koson/SmartFarmMySensors_ArduinoNano/3D/arduino-nano--1.snapshot.4/arduino nano290313/nanoblack_mask.bmp

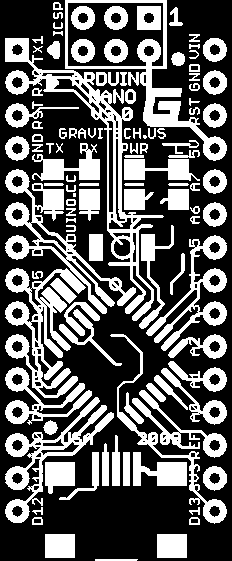
3D/arduino-nano--1.snapshot.4/arduino nano290313/nanoblack_mask.bmp
