koson/SmartFarmMySensors_ArduinoNano/3D/arduino-nano--1.snapshot.4/arduino nano290313/reset button.SLDASM

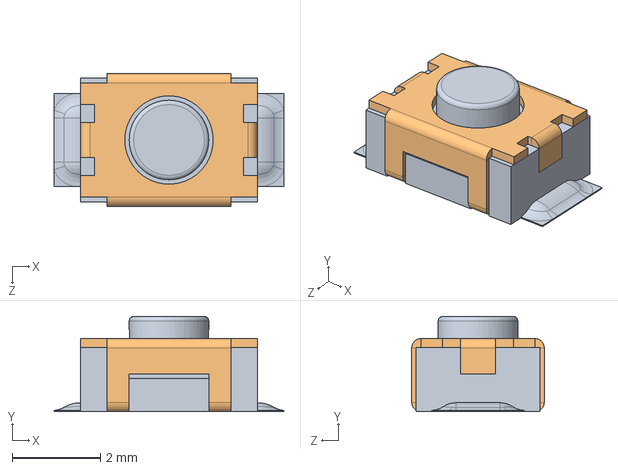
[picture p7: CAD file, 2025-02-11]
3D/arduino-nano--1.snapshot.4/arduino nano290313/reset button.SLDASM
5.20 x 2.15 x 3.00 mm
reset core
reset shell
