koson/SmartFarmMySensors_ArduinoNano/3D/arduino-nano--1.snapshot.4/arduino nano290313/MINIUSB - MEASURED.SLDASM

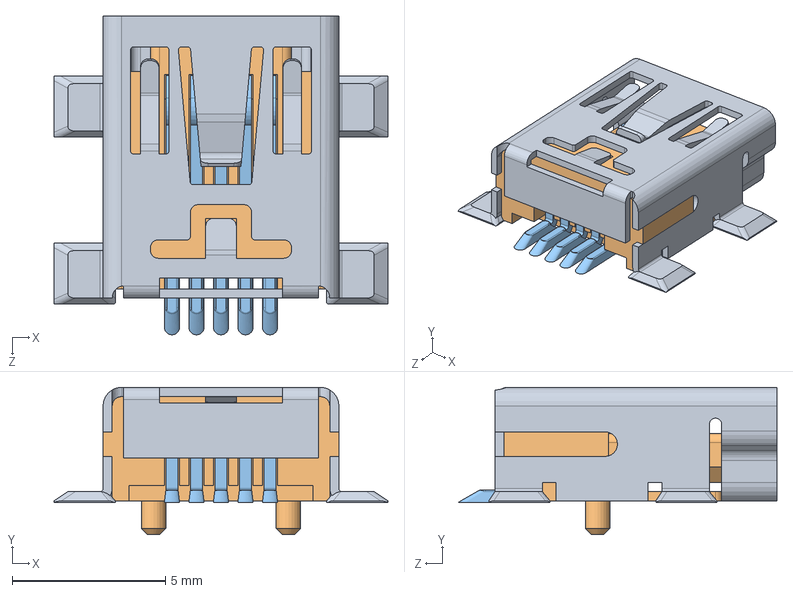
[picture p9: CAD file, 2025-02-11]
3D/arduino-nano--1.snapshot.4/arduino nano290313/MINIUSB - MEASURED.SLDASM
10.9 x 4.80 x 10.4 mm
MINIUSBSHELL
MINIUSBCORE
MINI USB CONTACT x 5
