koson/SmartFarmMySensors_ArduinoNano/3D/arduino-nano--1.snapshot.4/arduino nano290313/2pin_header__02.sldprt

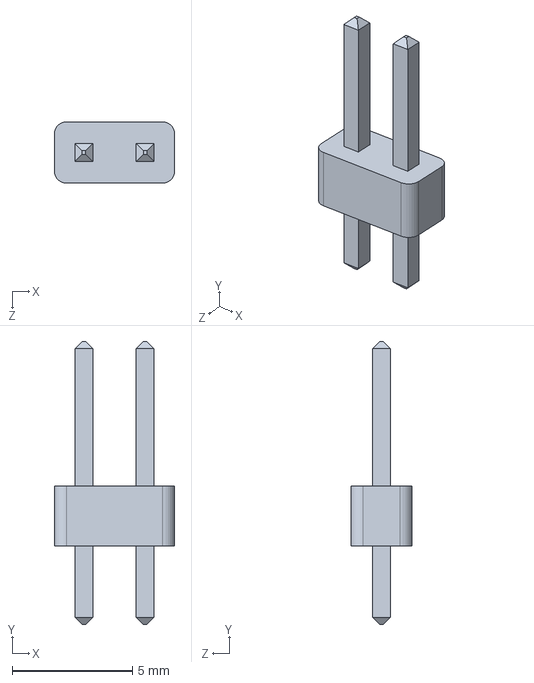
[picture p10: CAD file, 2025-02-11]
3D/arduino-nano--1.snapshot.4/arduino nano290313/2pin_header__02.sldprt
5.00 x 11.8 x 2.54 mm
