koson/SmartFarmMySensors_ArduinoNano/3D/RadioFrequencyCommunicationModule_nRF24L01.STEP

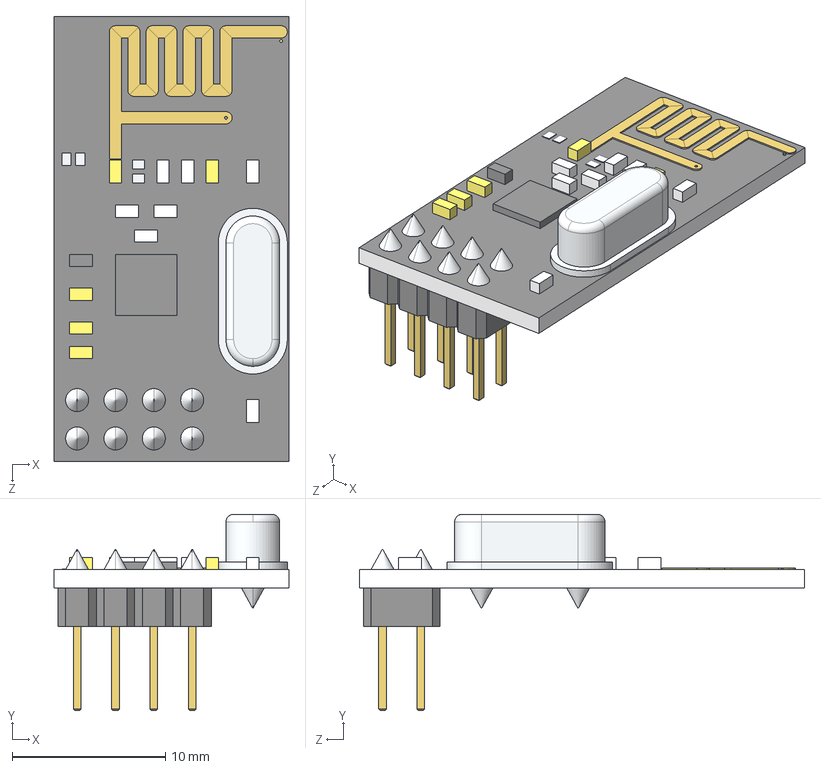
[picture p11: CAD file, 2025-02-11]
3D/RadioFrequencyCommunicationModule_nRF24L01.STEP
15.3 x 12.8 x 29.0 mm
