koson/SmartFarmMySensors_ArduinoNano/3D/arduino-nano--1.snapshot.4/arduino nano290313/reset core.SLDPRT

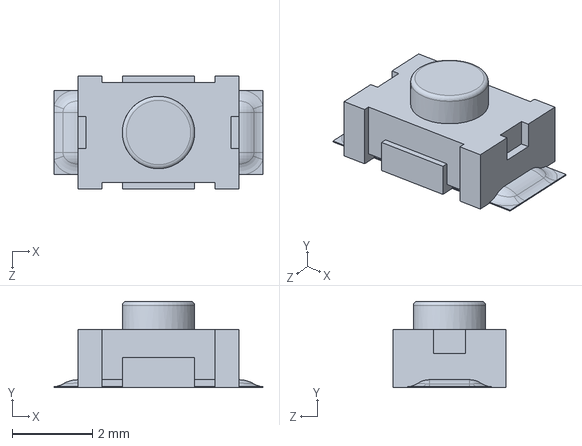
[picture p12: CAD file, 2025-02-11]
3D/arduino-nano--1.snapshot.4/arduino nano290313/reset core.SLDPRT
5.20 x 2.15 x 2.80 mm
