koson/SmartFarmMySensors_ArduinoNano/3D/arduino-nano--1.snapshot.4/arduino nano290313/cap106C.SLDPRT

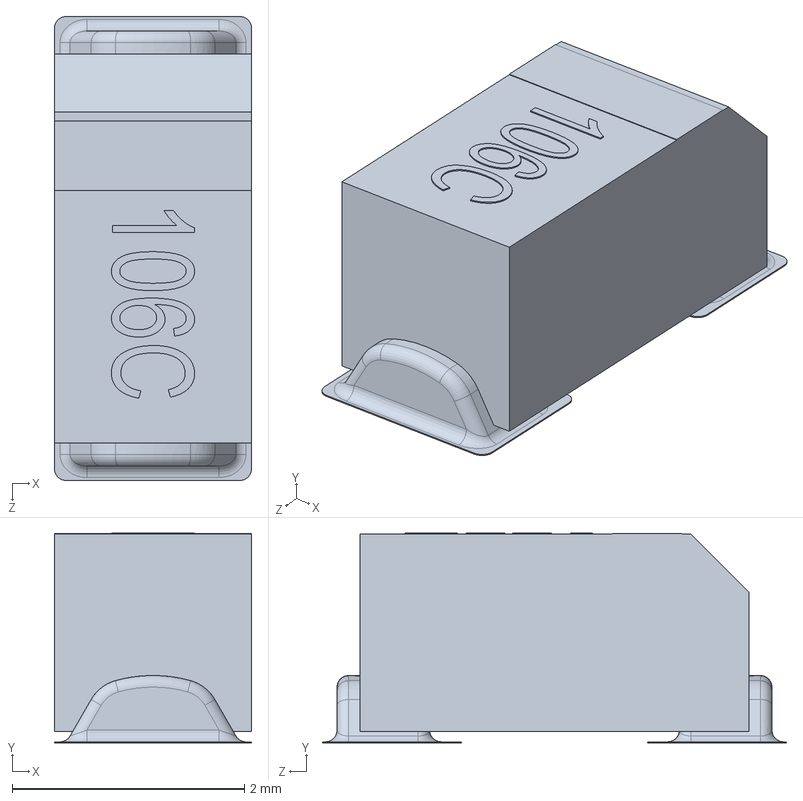
[picture p13: CAD file, 2025-02-11]
3D/arduino-nano--1.snapshot.4/arduino nano290313/cap106C.SLDPRT
1.70 x 1.81 x 4.00 mm
