koson/SmartFarmMySensors_ArduinoNano/3D/arduino-nano--1.snapshot.4/arduino nano290313/16mhz crystal - measured.SLDPRT

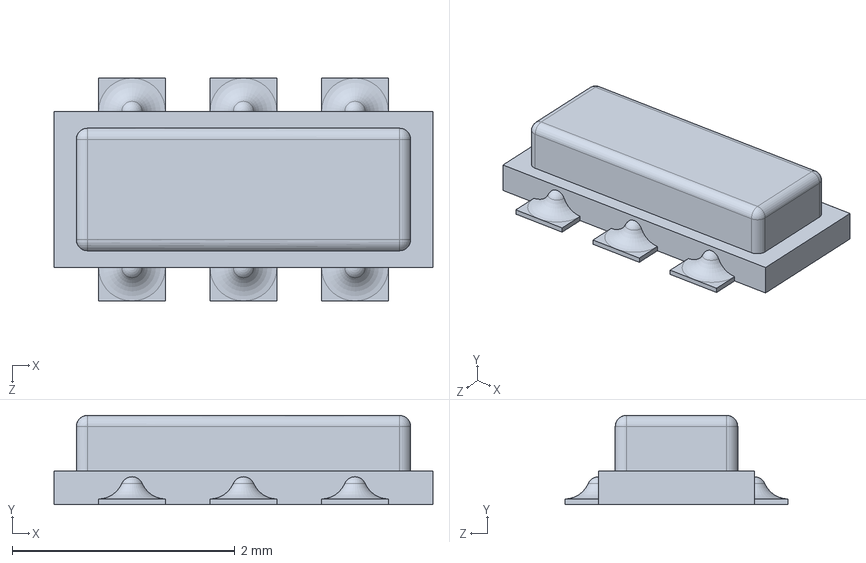
[picture p14: CAD file, 2025-02-11]
3D/arduino-nano--1.snapshot.4/arduino nano290313/16mhz crystal - measured.SLDPRT
3.40 x 0.8 x 2.00 mm
