koson/SmartFarmMySensors_ArduinoNano/3D/arduino-nano--1.snapshot.4/arduino nano290313/smt_resistor222.sldprt

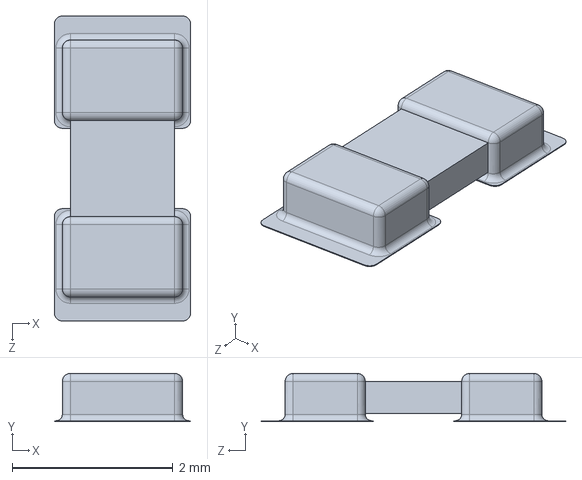
[picture p15: CAD file, 2025-02-11]
3D/arduino-nano--1.snapshot.4/arduino nano290313/smt_resistor222.sldprt
1.70 x 0.6 x 3.80 mm
