koson/SmartFarmMySensors_ArduinoNano/3D/arduino-nano--1.snapshot.4/arduino nano290313/led.SLDPRT

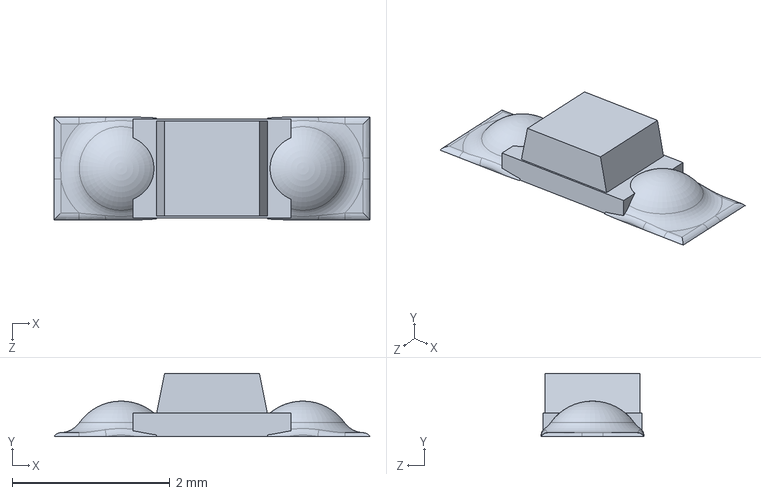
[picture p16: CAD file, 2025-02-11]
3D/arduino-nano--1.snapshot.4/arduino nano290313/led.SLDPRT
4.00 x 0.8 x 1.30 mm
