koson/SmartFarmMySensors_ArduinoNano/3D/arduino-nano--1.snapshot.4/arduino nano290313/MINI USB SOLDER.SLDPRT

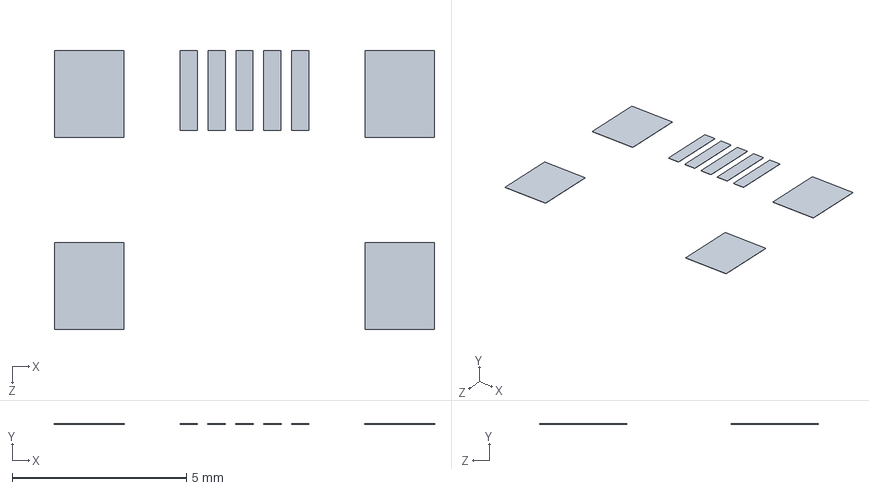
[picture p17: CAD file, 2025-02-11]
3D/arduino-nano--1.snapshot.4/arduino nano290313/MINI USB SOLDER.SLDPRT
10.9 x 0.01 x 8.00 mm
