koson/SmartFarmMySensors_ArduinoNano/3D/arduino-nano--1.snapshot.4/arduino nano290313/102 RESISTOR PACK.SLDPRT

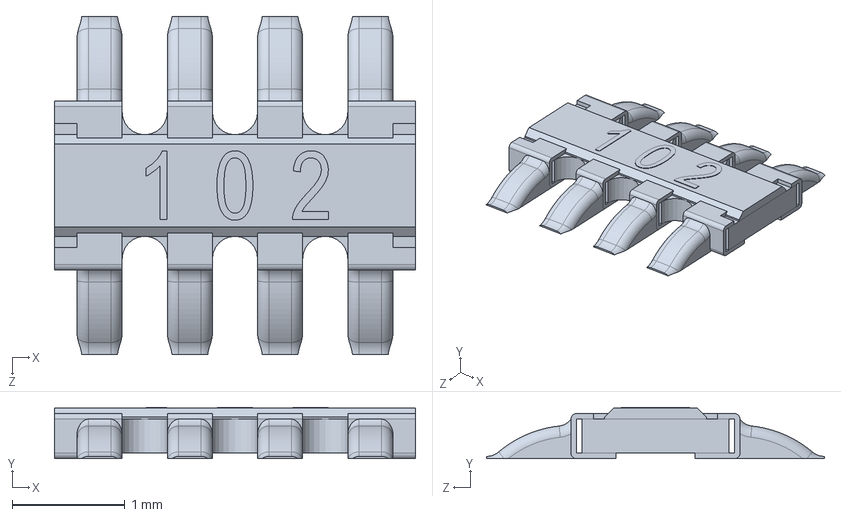
[picture p18: CAD file, 2025-02-11]
3D/arduino-nano--1.snapshot.4/arduino nano290313/102 RESISTOR PACK.SLDPRT
3.20 x 0.455 x 3.00 mm
