koson/SmartFarmMySensors_ArduinoNano/3D/arduino-nano--1.snapshot.4/arduino nano290313/nano-board.SLDPRT

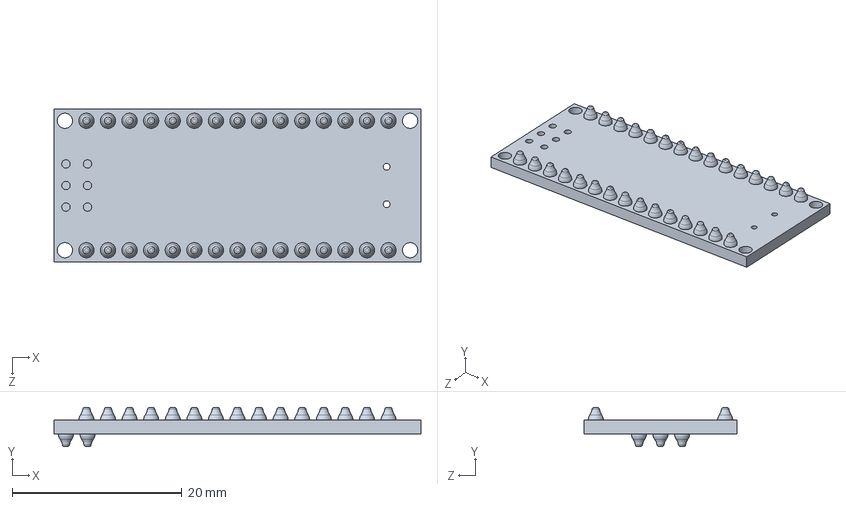
[picture p19: CAD file, 2025-02-11]
3D/arduino-nano--1.snapshot.4/arduino nano290313/nano-board.SLDPRT
43.2 x 4.60 x 18.0 mm
