koson/SmartFarmMySensors_ArduinoNano/3D/arduino-nano--1.snapshot.4/arduino nano290313/MINIUSBCORE.SLDPRT

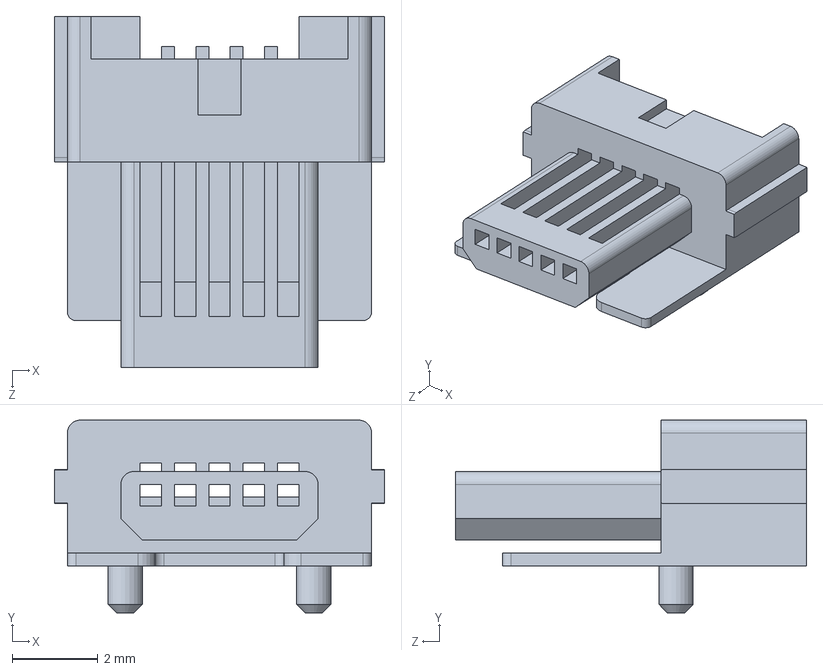
[picture p20: CAD file, 2025-02-11]
3D/arduino-nano--1.snapshot.4/arduino nano290313/MINIUSBCORE.SLDPRT
7.70 x 4.50 x 8.20 mm
