koson/SmartFarmMySensors_ArduinoNano/3D/arduino-nano--1.snapshot.4/arduino nano290313/ftdi FT232rl.SLDPRT

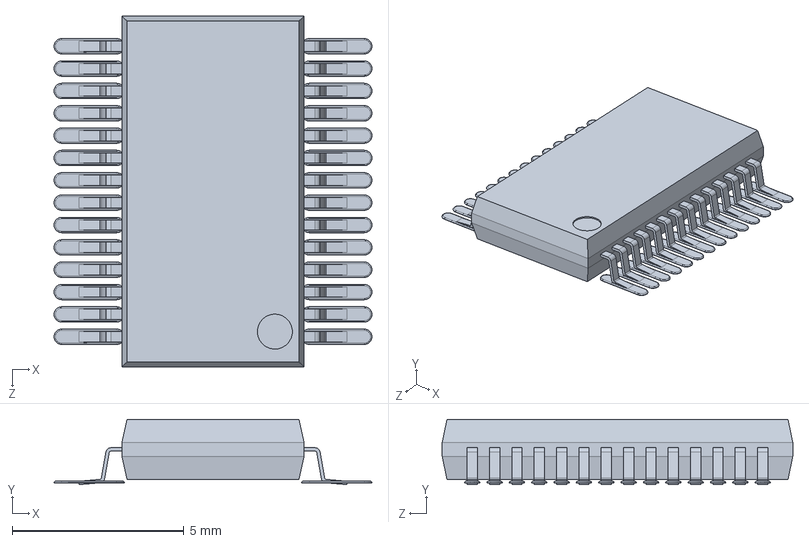
[picture p21: CAD file, 2025-02-11]
3D/arduino-nano--1.snapshot.4/arduino nano290313/ftdi FT232rl.SLDPRT
9.25 x 1.90 x 10.2 mm
