koson/SmartFarmMySensors_ArduinoNano/3D/arduino-nano--1.snapshot.4/arduino nano290313/nano - reg.SLDPRT

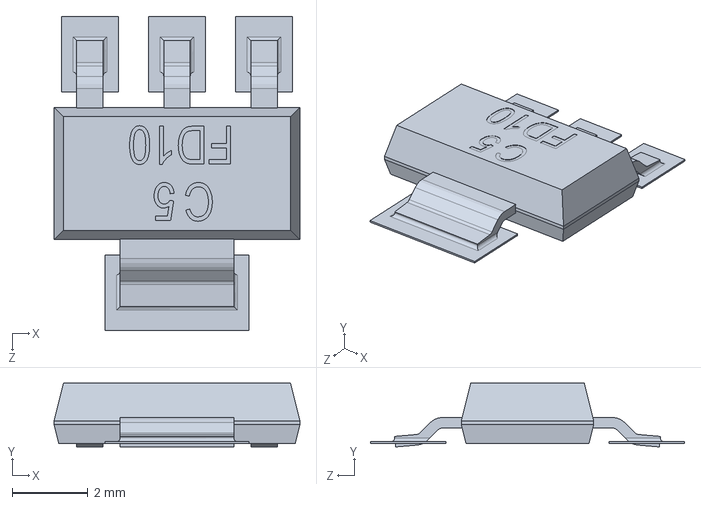
[picture p22: CAD file, 2025-02-11]
3D/arduino-nano--1.snapshot.4/arduino nano290313/nano - reg.SLDPRT
6.50 x 1.69 x 8.30 mm
