koson/SmartFarmMySensors_ArduinoNano/3D/arduino-nano--1.snapshot.4/arduino nano290313/reset shell.SLDPRT

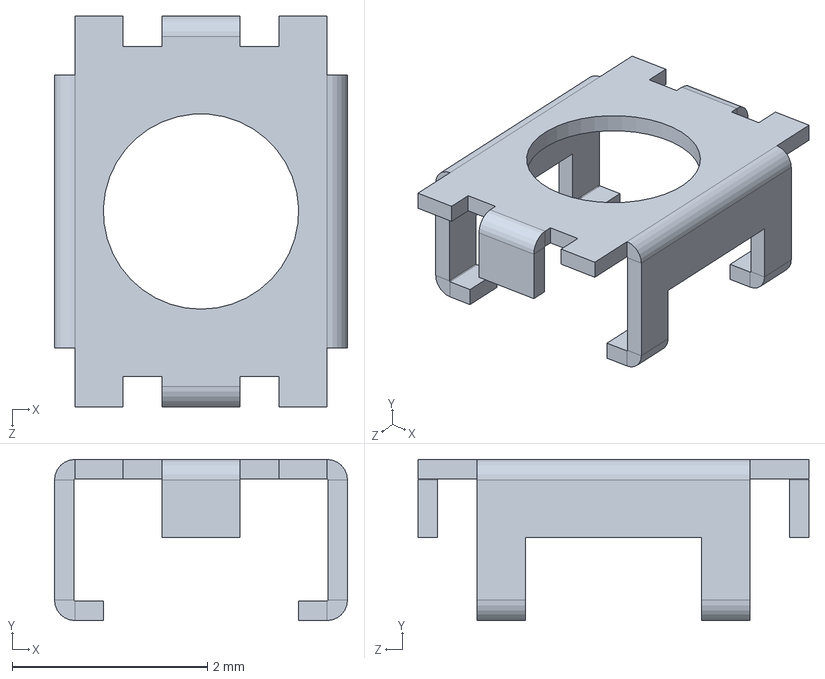
[picture p23: CAD file, 2025-02-11]
3D/arduino-nano--1.snapshot.4/arduino nano290313/reset shell.SLDPRT
3.00 x 1.65 x 4.00 mm
