koson/SmartFarmMySensors_ArduinoNano/3D/arduino-nano--1.snapshot.4/arduino nano290313/MINIUSBSHELL.SLDPRT

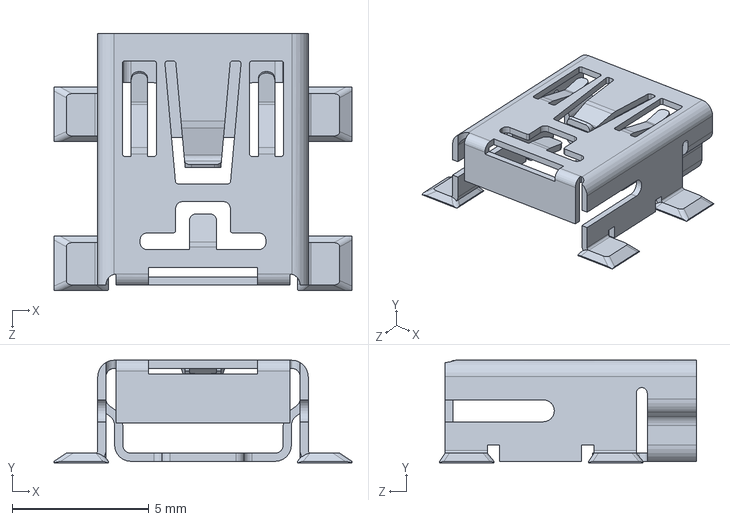
[picture p24: CAD file, 2025-02-11]
3D/arduino-nano--1.snapshot.4/arduino nano290313/MINIUSBSHELL.SLDPRT
10.9 x 3.75 x 9.40 mm
