koson/SmartFarmMySensors_ArduinoNano/3D/arduino-nano--1.snapshot.4/arduino nano290313/15pin_header__.sldprt

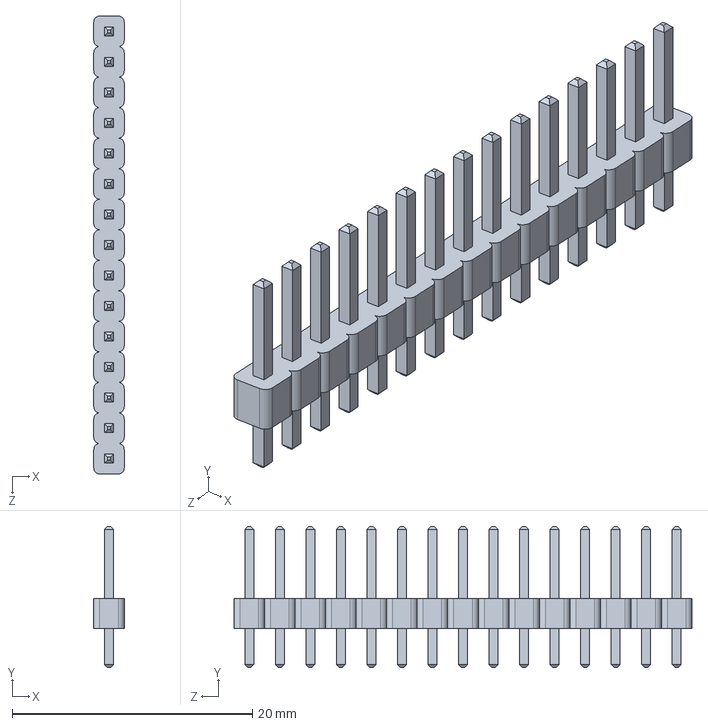
[picture p25: CAD file, 2025-02-11]
3D/arduino-nano--1.snapshot.4/arduino nano290313/15pin_header__.sldprt
2.54 x 11.8 x 38.1 mm
