koson/SmartFarmMySensors_ArduinoNano/3D/arduino-nano--1.snapshot.4/arduino nano290313/NANO DIODE.SLDPRT

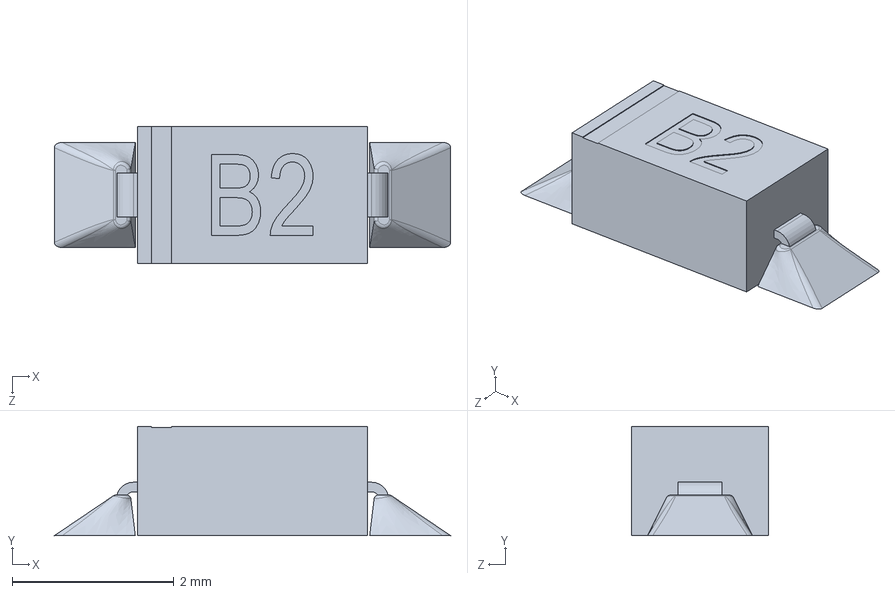
[picture p26: CAD file, 2025-02-11]
3D/arduino-nano--1.snapshot.4/arduino nano290313/NANO DIODE.SLDPRT
4.90 x 1.35 x 1.70 mm
