koson/SmartFarmMySensors_ArduinoNano/3D/arduino-nano--1.snapshot.4/arduino nano290313/MINI USB CONTACT.SLDPRT

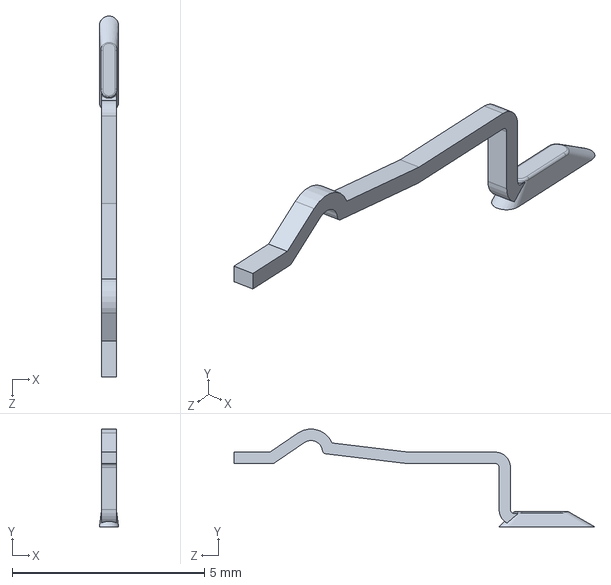
[picture p27: CAD file, 2025-02-11]
3D/arduino-nano--1.snapshot.4/arduino nano290313/MINI USB CONTACT.SLDPRT
0.5 x 2.55 x 9.40 mm
