koson/SmartFarmMySensors_ArduinoNano/(list of files, cad)

Other CAD files:
3D/arduino-nano--1.snapshot.4/arduino nano290313/189 RESISTOR PACK.SLDPRT
3D/RadioFrequencyCommunicationModule_nRF24L01.SLDPRT
