koson/SmartFarmMySensors_ArduinoNano/schematic.pdf

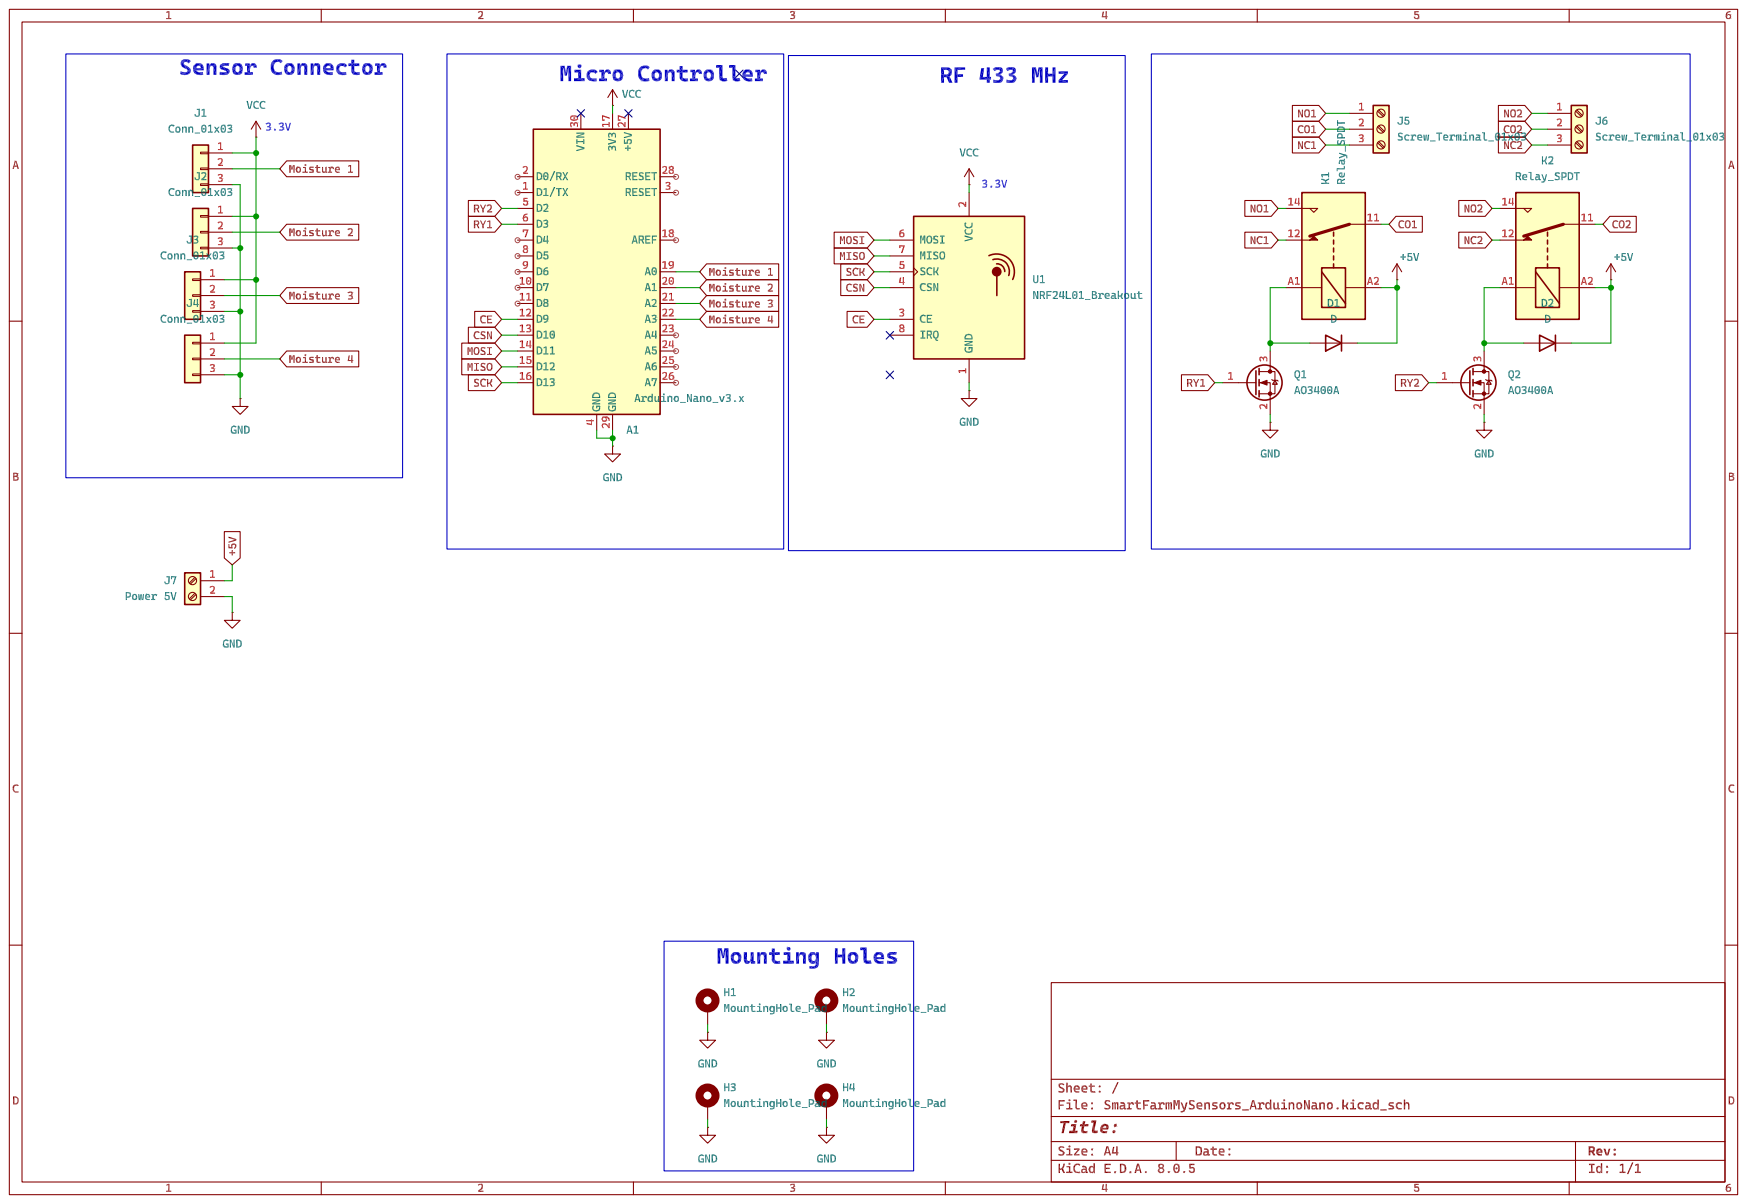
[picture p28: page 1]
