koson/SmartFarmMySensors_ArduinoNano/SmartFarmMySensors_ArduinoNano.kicad_pcb

## KiCad design SmartFarmMySensors_ArduinoNano.kicad_pcb (2025-02-11)

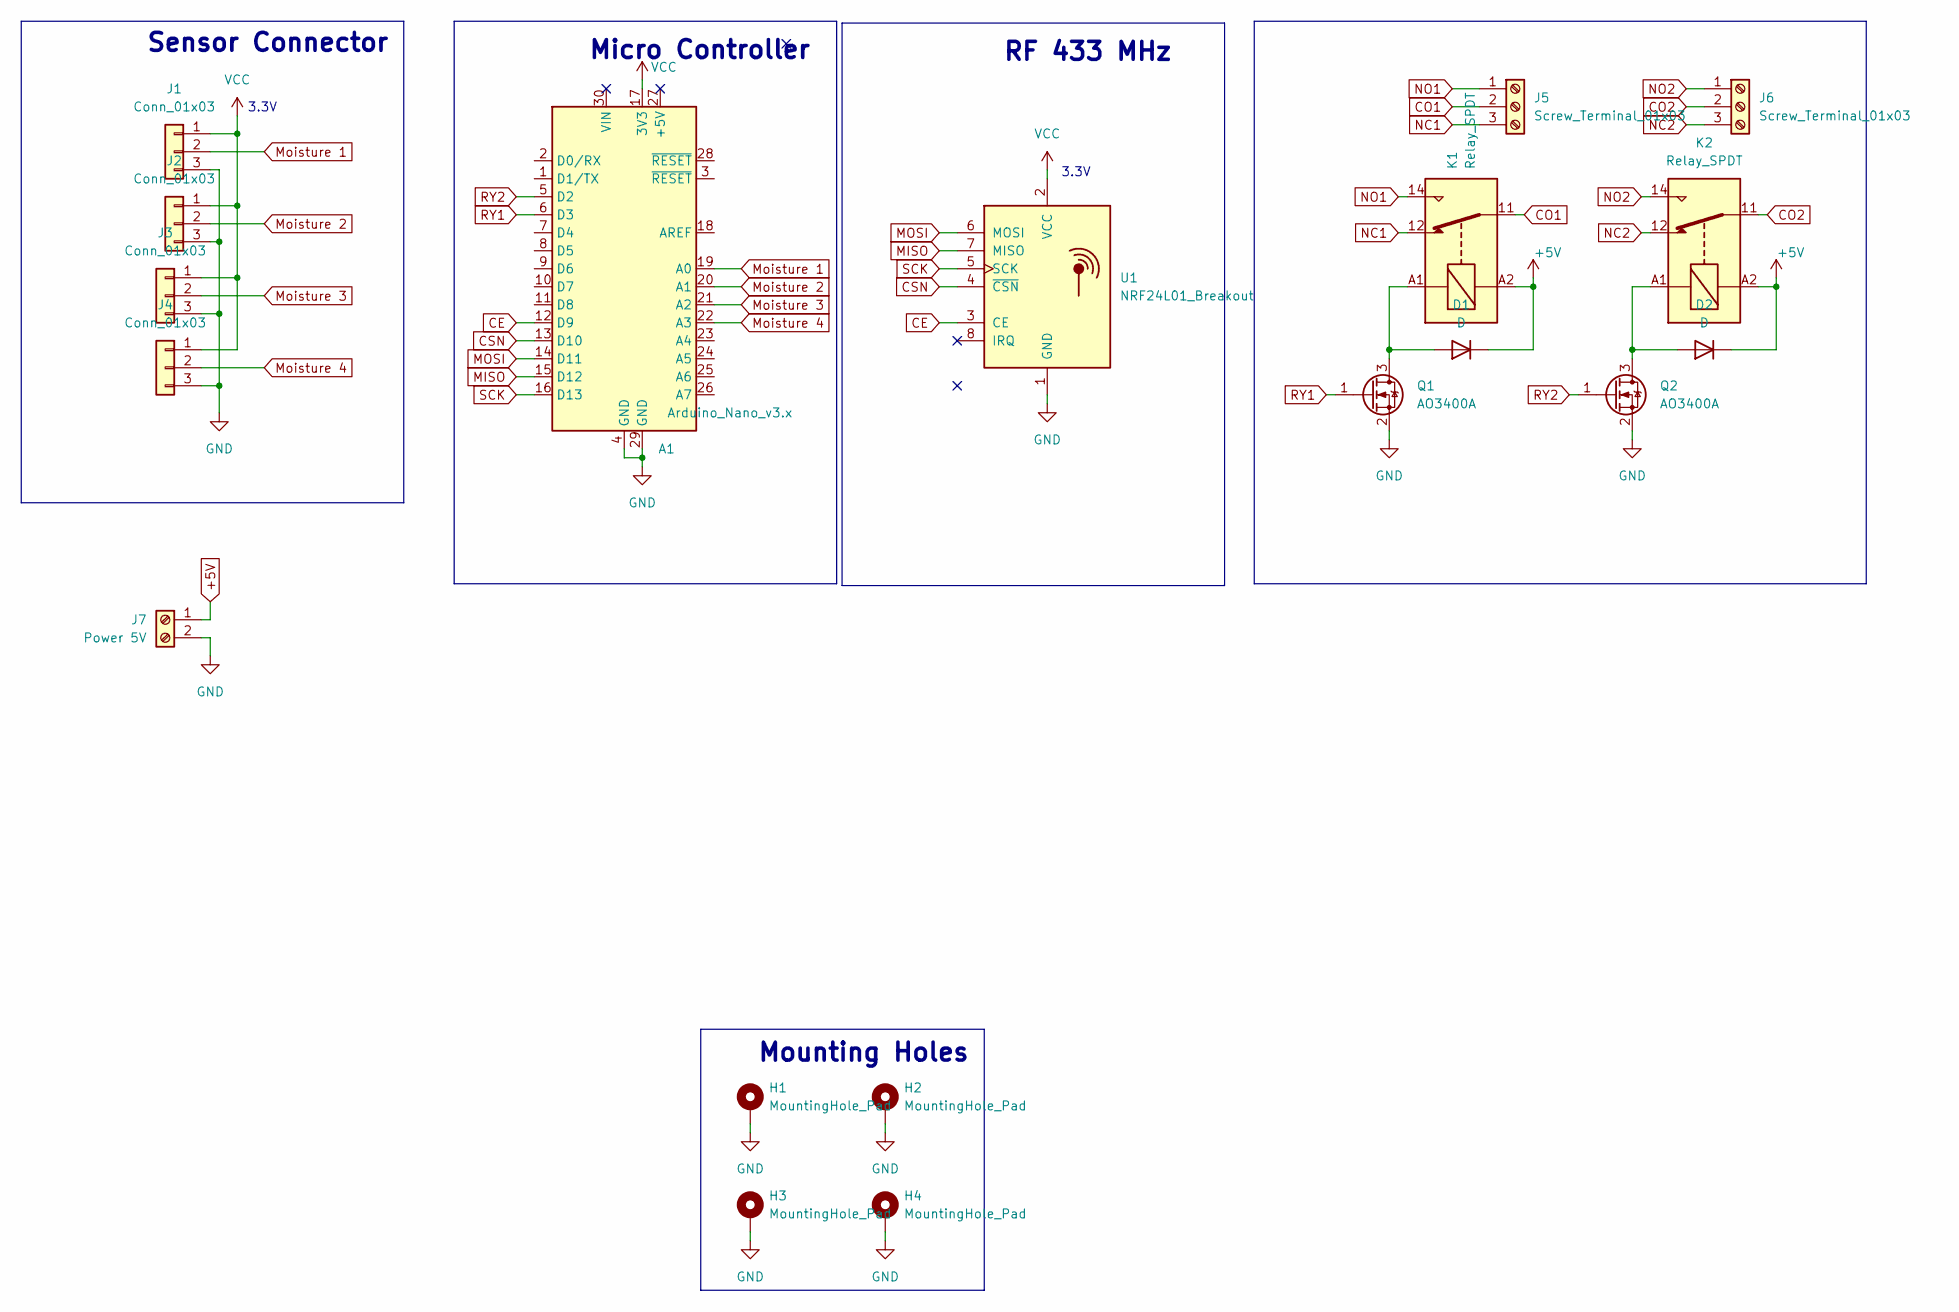
[picture p29: schematic SmartFarmMySensors_ArduinoNano.kicad_sch]

Parts:
A1: Arduino_Nano_v3.x; Arduino_Nano
D1, D2: D; D_SMA
H1, H2, H3, H4: MountingHole_Pad; MountingHole_3.2mm_M3_Pad_Via
J1, J2, J3, J4: Conn_01x03; JST_PH_B3B-PH-K_1x03_P2.00mm_Vertical
J5, J6: Screw_Terminal_01x03; TerminalBlock_Xinya_XY308-2.54-3P_1x03_P2.54mm_Horizontal
J7: Power 5V; TerminalBlock_Xinya_XY308-2.54-2P_1x02_P2.54mm_Horizontal
K1, K2: Relay_SPDT; Relay_SPDT_Finder_36.11
Q1, Q2: AO3400A; SOT-23
U1: NRF24L01_Breakout; nRF24L01_Breakout

Connections:
+5V: D1.1 (K), D2.1 (K), J7.1, K1.A2, K2.A2
CE: A1.12 (D9), U1.3 (CE)
CO1: J5.2, K1.11
CO2: J6.2, K2.11
CSN: A1.13 (D10), U1.4 (~CSN)
GND: A1.4 (GND), A1.29 (GND), H1.1, H2.1, H3.1, H4.1, J1.3, J2.3, J3.3, J4.3, J7.2, Q1.2 (S), Q2.2 (S), U1.1 (GND)
MISO: A1.15 (D12), U1.7 (MISO)
MOSI: A1.14 (D11), U1.6 (MOSI)
Moisture 1: A1.19 (A0), J1.2
Moisture 2: A1.20 (A1), J2.2
Moisture 3: A1.21 (A2), J3.2
Moisture 4: A1.22 (A3), J4.2
NC1: J5.3, K1.12
NC2: J6.3, K2.12
NO1: J5.1, K1.14
NO2: J6.1, K2.14
unnamed: D1.2 (A), K1.A1, Q1.3 (D)
unnamed: D2.2 (A), K2.A1, Q2.3 (D)
RY1: A1.6 (D3), Q1.1 (G)
RY2: A1.5 (D2), Q2.1 (G)
SCK: A1.16 (D13), U1.5 (SCK)
VCC: A1.17 (3V3), J1.1, J2.1, J3.1, J4.1, U1.2 (VCC)

Notes on the sheet:
Sensor Connector
RF 433 MHz
Mounting Holes
Micro Controller
3.3V

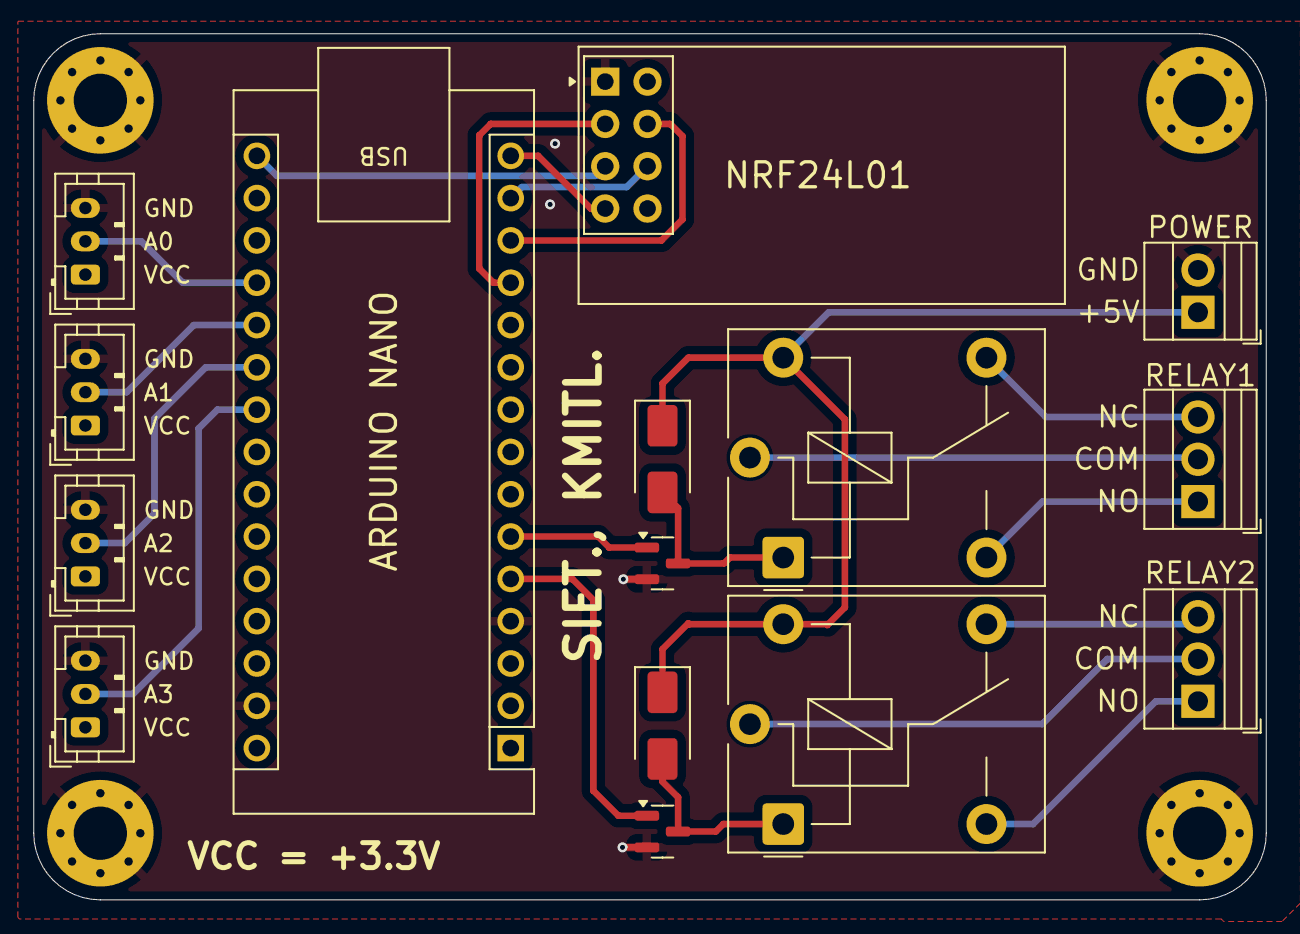
[picture p30: board SmartFarmMySensors_ArduinoNano.kicad_pcb from above]

Board: 4 copper layers, 74.0 x 52.0 mm, 19 parts (0 on the bottom side), 22 nets.
